blueskindesign/dmk20/README.md

# dmk20
dmk20 is a 17 or 20 key DIY mechanical keyboard. The 100% through-hole kit can be paired with your choice of Cherry MX style switches and keycaps for a numpad, macropad or even half of a 4×10 split ortholinear.

See docs/ for assembly instructions.
