blueskindesign/dmk20/dmk20.kicad_pcb

## KiCad design dmk20.kicad_pcb (2020-01-02)

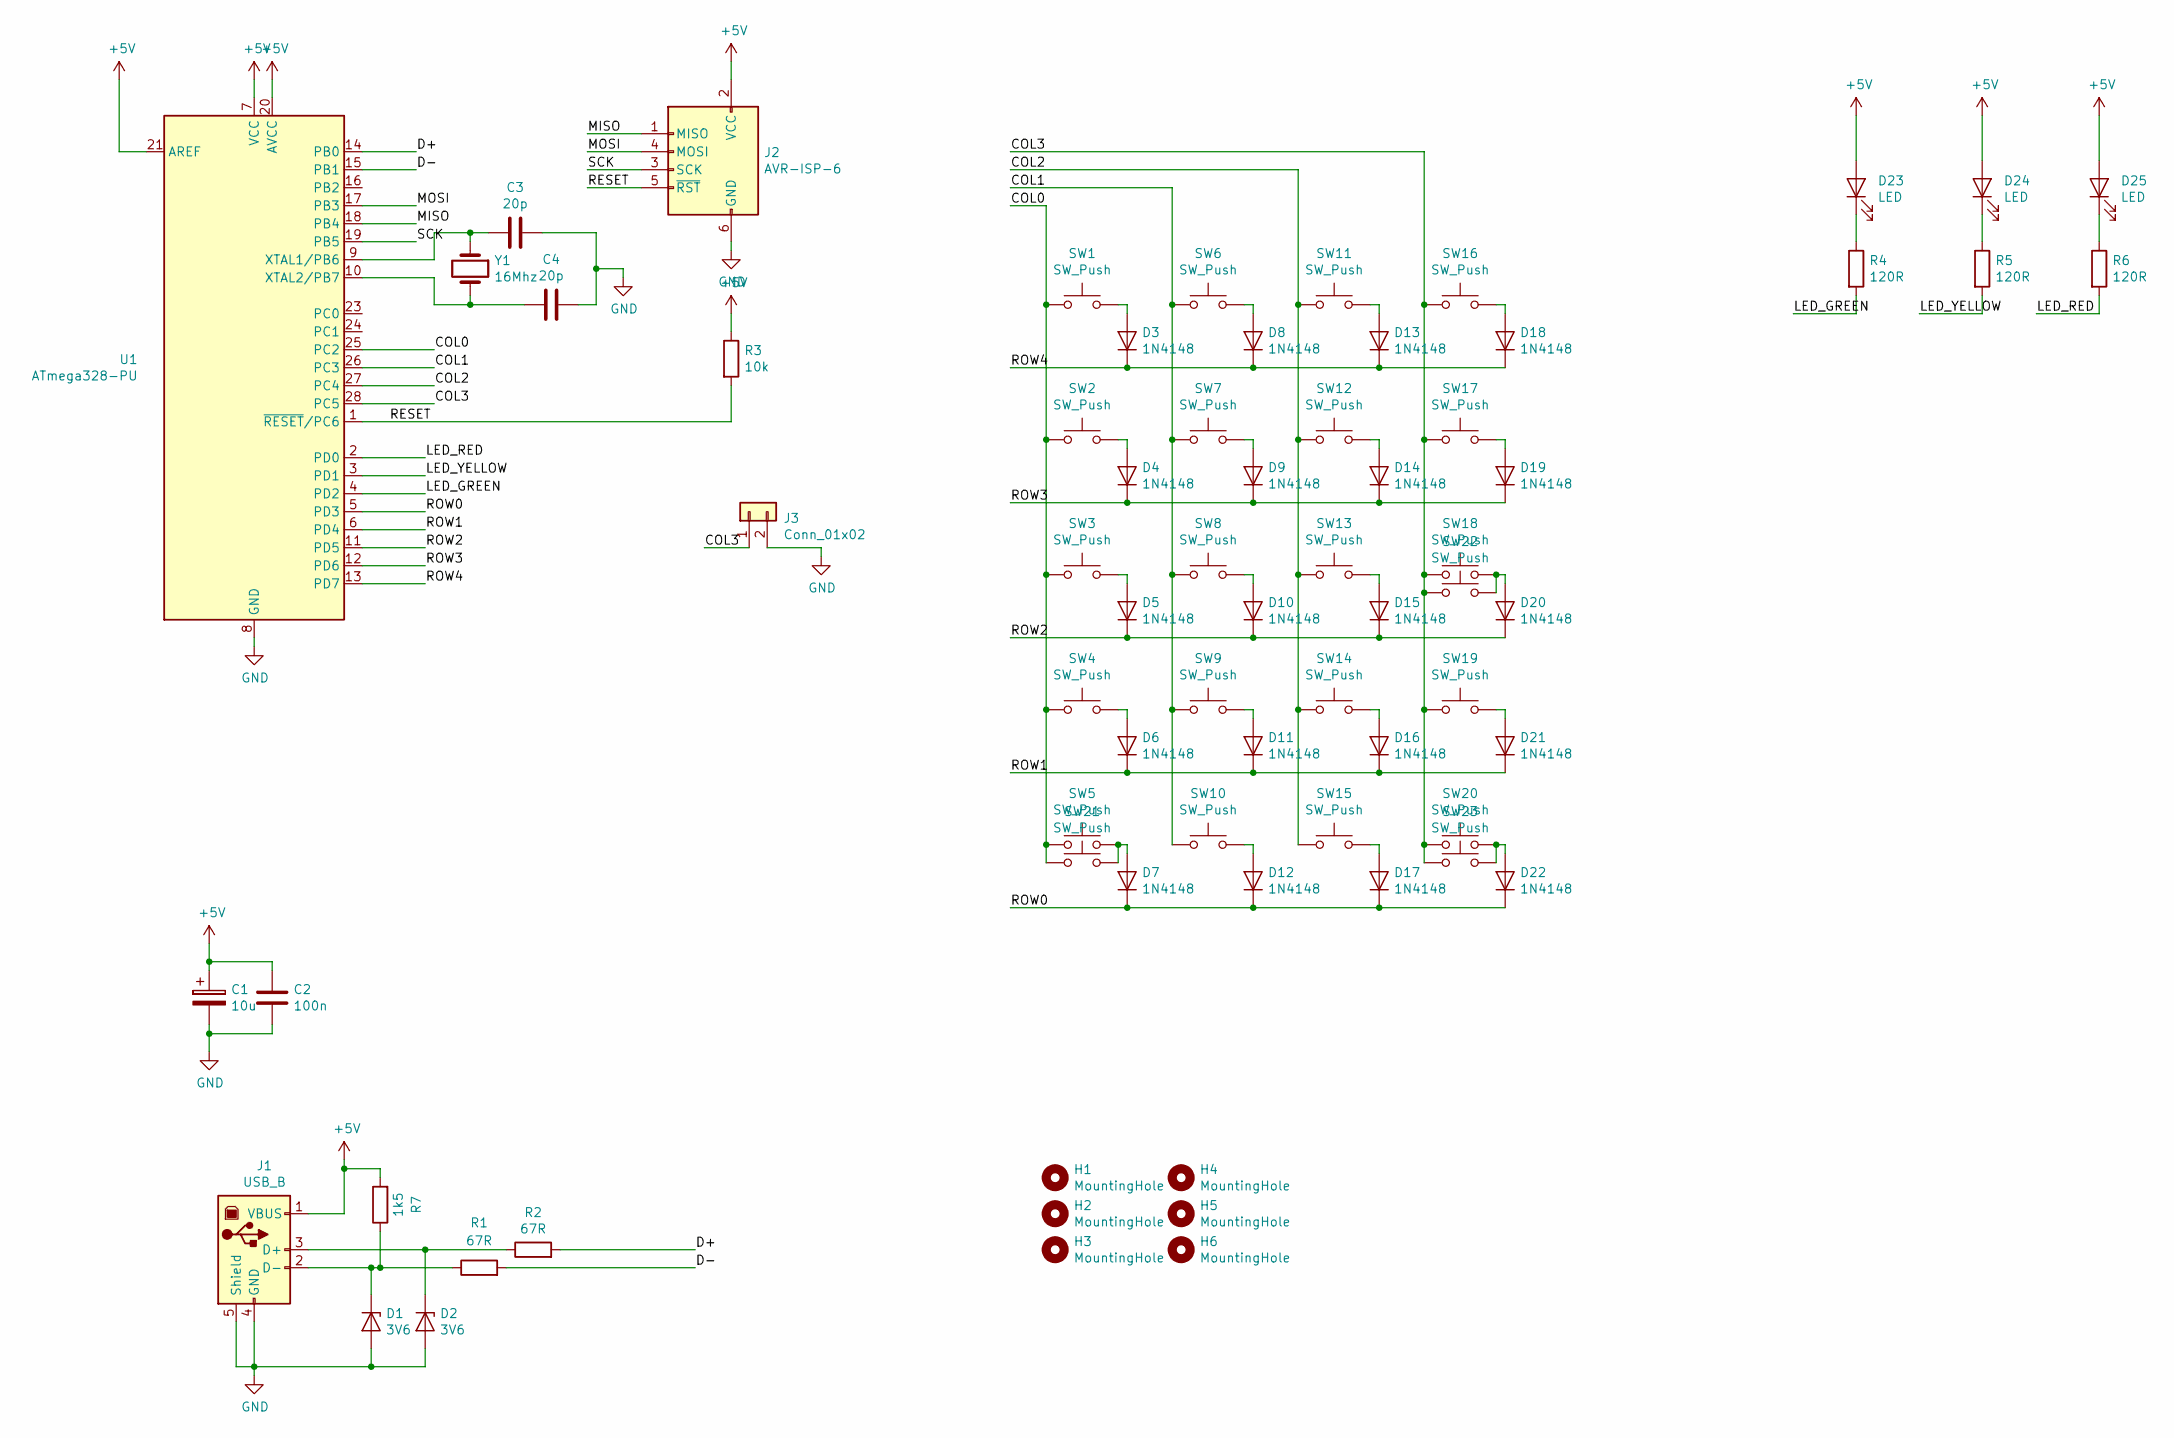
[picture p1: schematic dmk20.sch]

Parts:
C1: 10u; CP_Radial_D5.0mm_P2.00mm
C2: 100n; C_Disc_D4.3mm_W1.9mm_P5.00mm
C3, C4: 20p; C_Disc_D3.0mm_W1.6mm_P2.50mm
D1, D2: 3V6; D_T-1_P5.08mm_Horizontal
D3, D4, D5, D6, D7, D8, D9, D10, D11, D12, D13, D14, D15, D16, D17, D18, D19, D20, D21, D22: 1N4148; D_T-1_P5.08mm_Horizontal
D23, D24, D25: LED; LED_D3.0mm_Clear
H1, H2, H3, H4, H5, H6: MountingHole; MountingHole_2.2mm_M2_Pad
J1: USB_B; USB_B_OST_USB-B1HSxx_Horizontal
J2: AVR-ISP-6; PinHeader_2x03_P2.54mm_Vertical
J3: Conn_01x02; PinHeader_1x02_P2.54mm_Vertical
R1, R2: 67R; R_Axial_DIN0204_L3.6mm_D1.6mm_P5.08mm_Horizontal
R3: 10k; R_Axial_DIN0204_L3.6mm_D1.6mm_P5.08mm_Horizontal
R4, R5, R6: 120R; R_Axial_DIN0204_L3.6mm_D1.6mm_P5.08mm_Horizontal
R7: 1k5; R_Axial_DIN0204_L3.6mm_D1.6mm_P5.08mm_Horizontal
SW1, SW2, SW3, SW4, SW5, SW6, SW7, SW8, SW9, SW10, SW11, SW12, SW13, SW14, SW15, SW16, SW17, SW18, SW19, SW20: SW_Push; SW_Cherry_MX1A_1.00u_PCB
SW21: SW_Push; SW_Cherry_MX1A_2.00u_PCB
SW22, SW23: SW_Push; SW_Cherry_MX1A_2.00u_Vertical_PCB
U1: ATmega328-PU; DIP-28_W7.62mm
Y1: 16Mhz; Crystal_HC49-4H_Vertical

Connections:
+5V: C1.1, C2.1, D23.2 (A), D24.2 (A), D25.2 (A), J1.1 (VBUS), J2.2 (VCC), R3.1, R7.2, U1.7 (VCC), U1.20 (AVCC), U1.21 (AREF)
/COL0: SW1.1, SW2.1, SW3.1, SW4.1, SW5.1, SW21.1, U1.25 (PC2)
/COL1: SW6.1, SW7.1, SW8.1, SW9.1, SW10.1, U1.26 (PC3)
/COL2: SW11.1, SW12.1, SW13.1, SW14.1, SW15.1, U1.27 (PC4)
/COL3: J3.1, SW16.1, SW17.1, SW18.1, SW19.1, SW20.1, SW22.1, SW23.1, U1.28 (PC5)
/D+: R2.2, U1.14 (PB0)
/D-: R1.2, U1.15 (PB1)
/LED_GREEN: R4.2, U1.4 (PD2)
/LED_RED: R6.2, U1.2 (PD0)
/LED_YELLOW: R5.2, U1.3 (PD1)
/MISO: J2.1 (MISO), U1.18 (PB4)
/MOSI: J2.4 (MOSI), U1.17 (PB3)
/RESET: J2.5 (~RST), R3.2, U1.1 (~RESET~/PC6)
/ROW0: D7.1 (K), D12.1 (K), D17.1 (K), D22.1 (K), U1.5 (PD3)
/ROW1: D6.1 (K), D11.1 (K), D16.1 (K), D21.1 (K), U1.6 (PD4)
/ROW2: D5.1 (K), D10.1 (K), D15.1 (K), D20.1 (K), U1.11 (PD5)
/ROW3: D4.1 (K), D9.1 (K), D14.1 (K), D19.1 (K), U1.12 (PD6)
/ROW4: D3.1 (K), D8.1 (K), D13.1 (K), D18.1 (K), U1.13 (PD7)
/SCK: J2.3 (SCK), U1.19 (PB5)
GND: C1.2, C2.2, C3.1, C4.1, D1.2 (A), D2.2 (A), J1.4 (GND), J1.5 (Shield), J2.6 (GND), J3.2, U1.8 (GND), U1.22 (GND)
unnamed: C3.2, U1.9 (XTAL1/PB6), Y1.1
unnamed: C4.2, U1.10 (XTAL2/PB7), Y1.2
unnamed: D1.1 (K), J1.2 (D-), R1.1, R7.1
unnamed: D2.1 (K), J1.3 (D+), R2.1
unnamed: D3.2 (A), SW1.2
unnamed: D4.2 (A), SW2.2
unnamed: D5.2 (A), SW3.2
unnamed: D6.2 (A), SW4.2
unnamed: D7.2 (A), SW5.2, SW21.2
unnamed: D8.2 (A), SW6.2
unnamed: D9.2 (A), SW7.2
unnamed: D10.2 (A), SW8.2
unnamed: D11.2 (A), SW9.2
unnamed: D12.2 (A), SW10.2
unnamed: D13.2 (A), SW11.2
unnamed: D14.2 (A), SW12.2
unnamed: D15.2 (A), SW13.2
unnamed: D16.2 (A), SW14.2
unnamed: D17.2 (A), SW15.2
unnamed: D18.2 (A), SW16.2
unnamed: D19.2 (A), SW17.2
unnamed: D20.2 (A), SW18.2, SW22.2
unnamed: D21.2 (A), SW19.2
unnamed: D22.2 (A), SW20.2, SW23.2
unnamed: D23.1 (K), R4.1
unnamed: D24.1 (K), R5.1
unnamed: D25.1 (K), R6.1

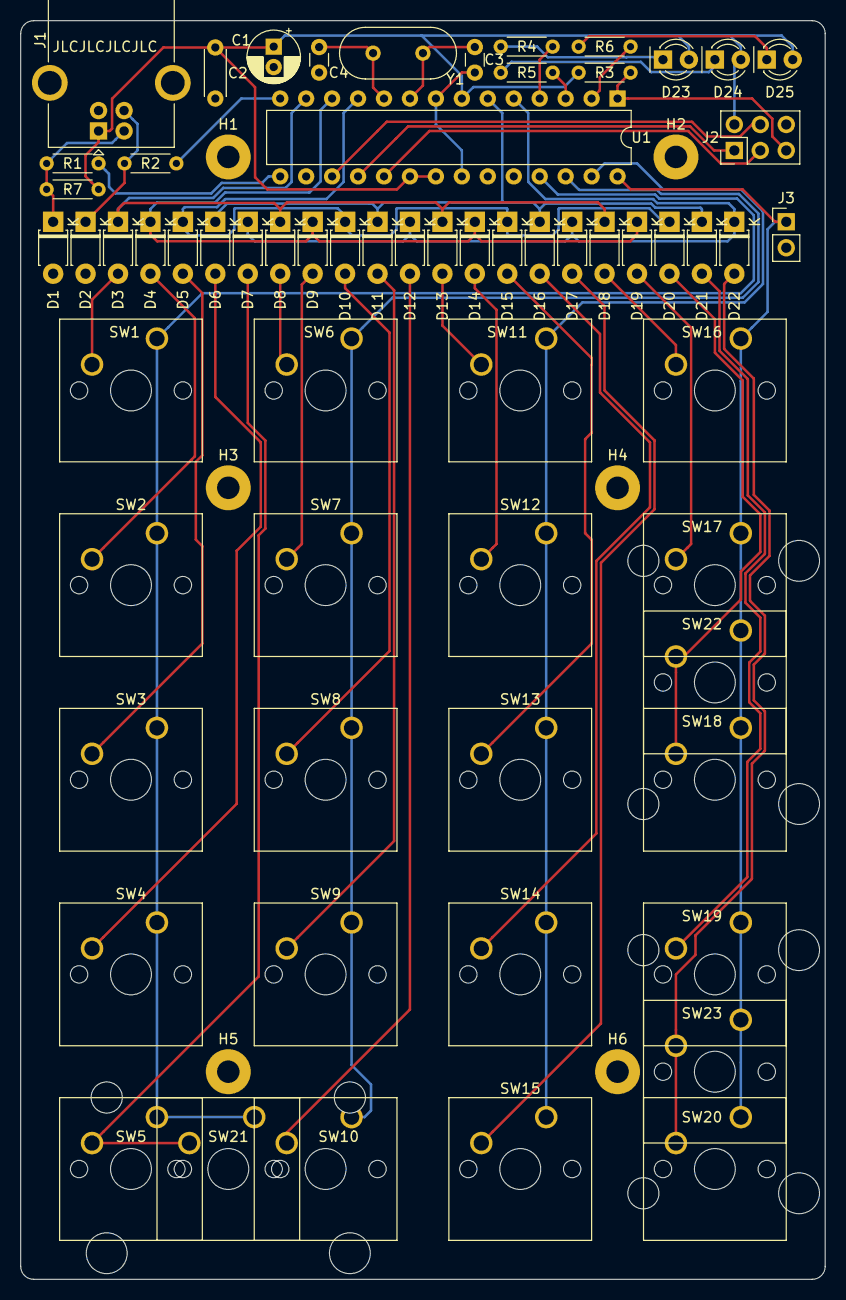
[picture p2: board dmk20.kicad_pcb from above]

Board: 2 copper layers, 78.7 x 123.2 mm, 70 parts (0 on the bottom side), 47 nets.
