blueskindesign/dmk20/docs/dmk20 Assembly Instructions.odt

dmk20 Assembly Instructions

Tools Required:

1. Soldering iron – For best results a temperature controlled iron is easier to use
2. Solder – 60/40 rosin core solder is the easiest to use, but is getting harder to find due to the lead content. Any high quality leaded or lead-free solder can be used.
3. Diagonal flush cutters
4. A small flat head screw driver
5. Desoldering wick – This may not be necessary but if you need to remove a component for any reason it makes it a lot easier.

Additional Parts Required:

1. 17 – 20 MX style keyboard switches.
2. 3x 2u stabilizers. These are only necessary if you want to build a numpad. The keyboard will work without them but they will stop the larger keys from rocking if pressed on the side.
3. A USB type B Cable.

Instructions:

1. Install D1 & D2 (3V6 Zener Diodes) NOTE: These components must be installed in the correct orientation.
  These are the left two most diodes and are different from the other diodes on the board. They are installed with the cathode (black stripe on the body) at the top of the board.
2. Install D3 – D22 (1N4148 Signal Diodes)
  NOTE: These components must be installed in the correct orientation.
  These are the remainder of the diodes and are installed with the cathode (black stripe on the body) at the top of the board (the same orientation as D1 & D2)
3. Install R1 & R2 (68R Resistors)
  These are the two resistors immediately underneath the USB connector.
4. Install R7 (1k5 Resistor)
  This is immediately underneathe R1
5. Install R4 – R6 (220R Resistors)
6. Install R3 (10k Resistor)
7. Install U1 (ATMega328-PU Microcontroller)
  NOTE: This component must be installed in the correct orientation.
  The notch at the end of the Microcontroller (between pins 1 & 28) should be on the right hand side of the board. It may be necessary to bend the pins slightly to get them to fit in the holes. It is recommended to use a stiff straight edge (such as a ruler) to gently squash the pins against a solid surface.
8. Install Y1 (16MHz Crystal)
9. Install C3 & C4 (20pF Ceramic Capacitor)
10. Install C2 (100nF Ceramic Capacitor)
11. Install C1 (10uF Electrolytic Capacitor)
12. Install D23 – D25 (Green, Yellow & Red LEDs) NOTE: These components must be installed in the correct orientation. The cathode of the LED (there is a flat on the cathode side of the LED base, the shorter leg is also the cathode) must be installed facing to the left. The colour choice is up to the installer, but to match the LED names in the software we use D23 = Green, D24 = Yellow, D25 = Red
13. Install J1 (USB Type B Socket)
14. Install J2 (AVR 6-pin ISP Header)
15. Install the backboard spacers (4mm M2 standoffs) Use the slotted screws for the lower four standoffs (H3-H6) and the 12mm standoffs for the upper two (H1 & H2)
16. Install the switches (SW1 – SW23)
  OPTION 1 (Numpad): Install SW1-4, SW6-9, SW11-18, SW21-23
  Add the PCB mount stabilizers either side of SW21-23  It is important that the switches are fully pressed into the board to ensure that they keycaps end up properly aligned.
17. Install the baseboard. Use the M2 nuts to secure the baseboard to the bottom of the standoffs.
18. Install the protective window. Remove the protective paper from the window and use the remaining slotted screws to affix it to the top of the 12mm standoffs.
19. Install your keycaps.
20. Plug the keyboard into a USB cable attached to a computer. The three LEDs should briefly illuminate before displaying the current status of the Numlock & Capslock (D23 and D24 respectively). Your new numpad should now be working, Enjoy!   If you want to change the software see our qmk update guide.
