blueskindesign/dmk20/(commit log)

2020-01-02 Initial commit.
    [dmk20.csv, dmk20.kicad_pcb, dmk20.sch]
2020-01-07 added assembly instructions
