blueskindesign/dmk20/(notices)

Notices in the files:
dmk20.kicad_pcb:
(C) 2019 Blueskin Design Ltd
